a1k0n/tt08-vgademo/README.md

   

# Tiny Tapeout Verilog Project - a1k0n's democompo entry

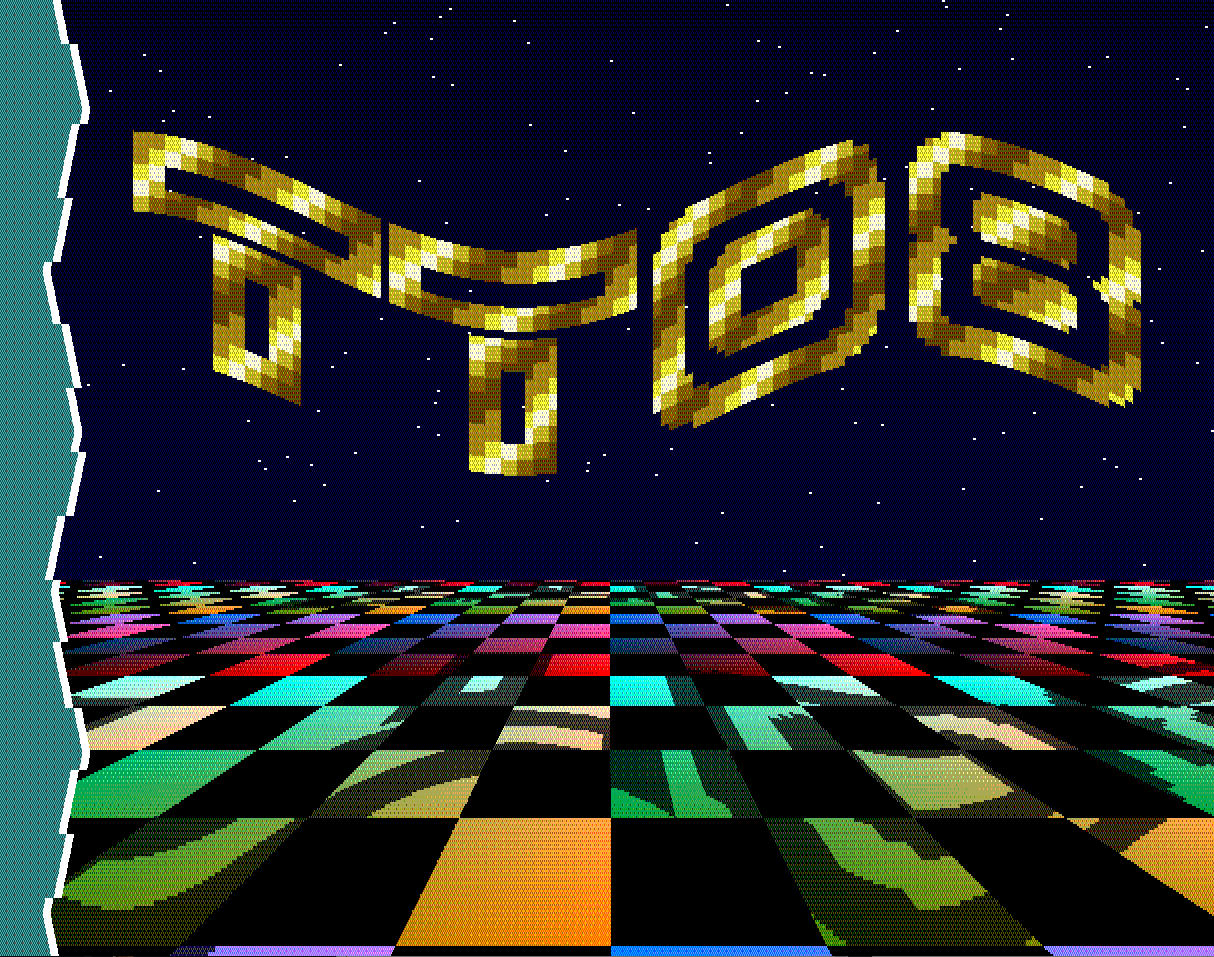
[picture p1: docs/preview.png]
preview


- [Read the documentation for project](docs/info.md)

## What is Tiny Tapeout?

Tiny Tapeout is an educational project that aims to make it easier and cheaper than ever to get your digital and analog designs manufactured on a real chip.

To learn more and get started, visit https://tinytapeout.com.

## What is this?

This is a1k0n's first tinytapeout project, and an entry in the first [Tiny
Tapeout demo competition](https://tinytapeout.com/competitions/demoscene/).
