a1k0n/tt08-vgademo/(commit log)

2024-08-06 ensure outputs are registered
    === demo_orangecrab ===
    Number of wires: 1933
    Number of wire bits: 3151
    Number of public wires: 1933
    Number of public wire bits: 3151
    Number of ports: 10
    Number of port bits: 10
    Number of memories: 0
    Number of memory bits: 0
    Number of processes: 0
    Number of cells: 2021
    $scopeinfo 4
    CCU2C 204
    L6MUX21 194
    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
2024-08-06 remove multiplier (at least on FPGA..)
    Number of wires: 1952
    Number of wire bits: 3204
    Number of public wires: 1952
    Number of public wire bits: 3204
    Number of cells: 2055
    CCU2C 205
    L6MUX21 189
    LUT4 1077
    PFUMX 382
    TRELLIS_FF 198
    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
2024-08-09 donut has been achieved internally
    i tried too hard to string a bunch of comb logic into a single cycle
    and... it won't work on an FPGA, but it might build on an asic??
    anyway the donut is super super wonky anyway
    [vgademo.v]
2024-08-11 switching verilog ordering to hopefully pass DRC
2024-08-14 audio! trying out some raymaching shortcuts
    but... everything takes too much area! arrrggghhh!
    [audiotrack.v, demo_orangecrab.v, tt_um_a1k0n_demo.v, vgademo.v]
2024-08-14 verilate the audio track
    efficiently skips the sigma-delta modulator, blasts samples to SDL
    [audiotrack.v]
2024-08-17 sync reset audio+vga; easy win
    [audiotrack.v, vgademo.v]
2024-08-20 reduce internal sigma-delta sample depth to 8 bits
2024-08-28 fix test issues and missing files
    [vgademo.v]
2024-08-28 remove extra ; for an extra picky icarus version
    also add the missing README
    [audiotrack.v]
2024-08-29 fix unspecified bit width
    [vgademo.v]
2024-09-02 cleanup, fix dithering, emulate audio harmonic distortion
    [vgademo.v]
2024-09-06 free up some ffs, bonus glitch effect
    [vgademo.v]
2024-09-06 verilog permute just in case of feol failure
